sKulll-J/Stage_LoRa_2024/VSE_R&S/example complet.JPG

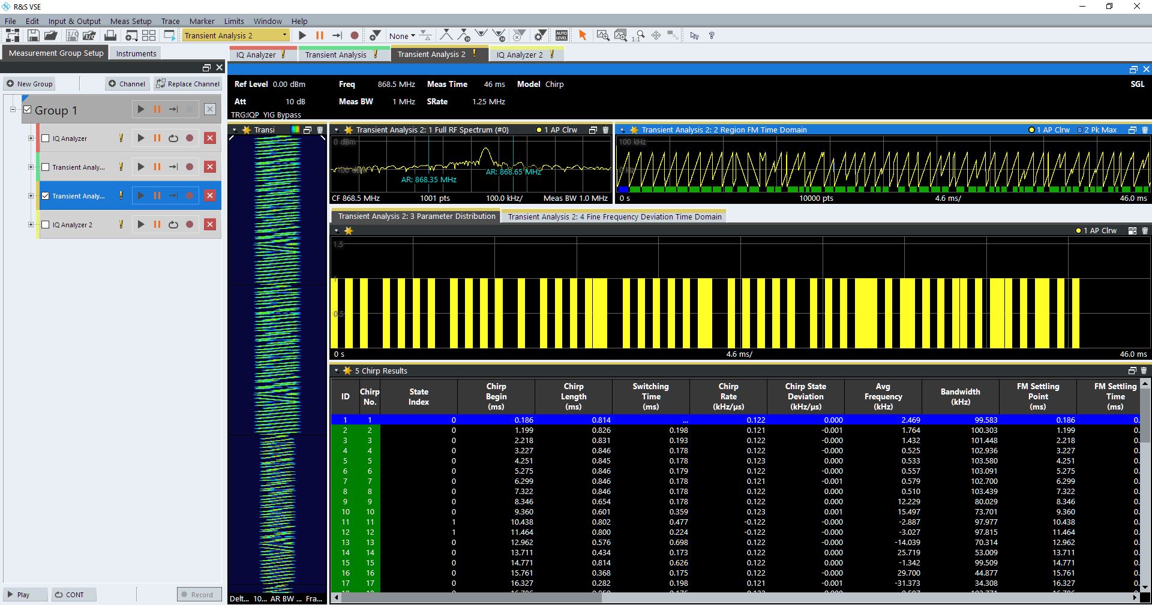
VSE_R&S/example complet.JPG
