sKulll-J/Stage_LoRa_2024/VSE_R&S/new_mode_1.JPG

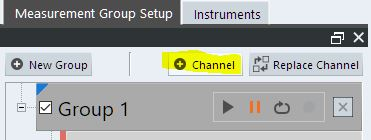
VSE_R&S/new_mode_1.JPG
