sKulll-J/Stage_LoRa_2024/CapteursInfos/AnalyseLora/SF7_s1_pw6.JPG

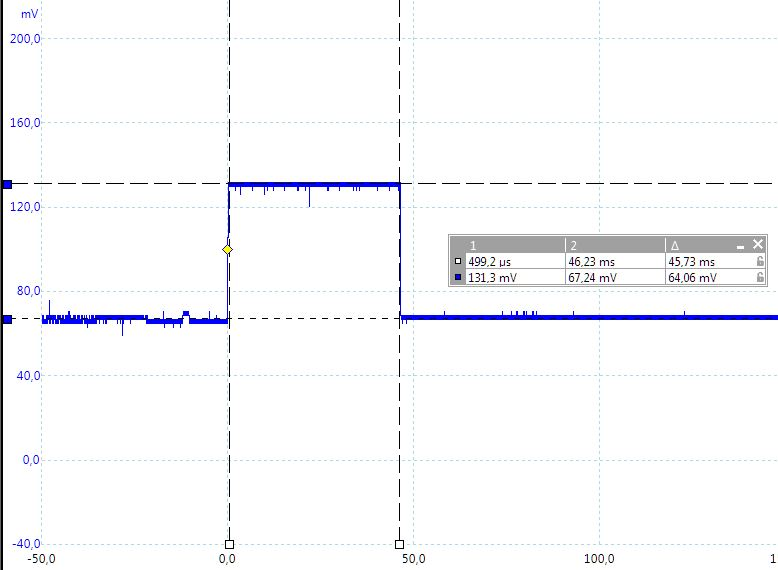
CapteursInfos/AnalyseLora/SF7_s1_pw6.JPG
