sKulll-J/Stage_LoRa_2024/CapteursInfos/AnalyseLora/SF7_s50_pw14.JPG

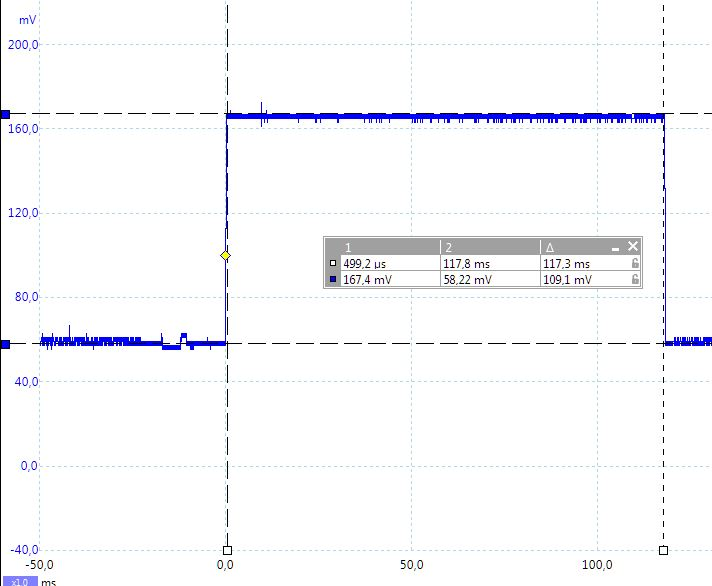
CapteursInfos/AnalyseLora/SF7_s50_pw14.JPG
