sKulll-J/Stage_LoRa_2024/CapteursInfos/AnalyseLora/SF9_s1_pw14.JPG

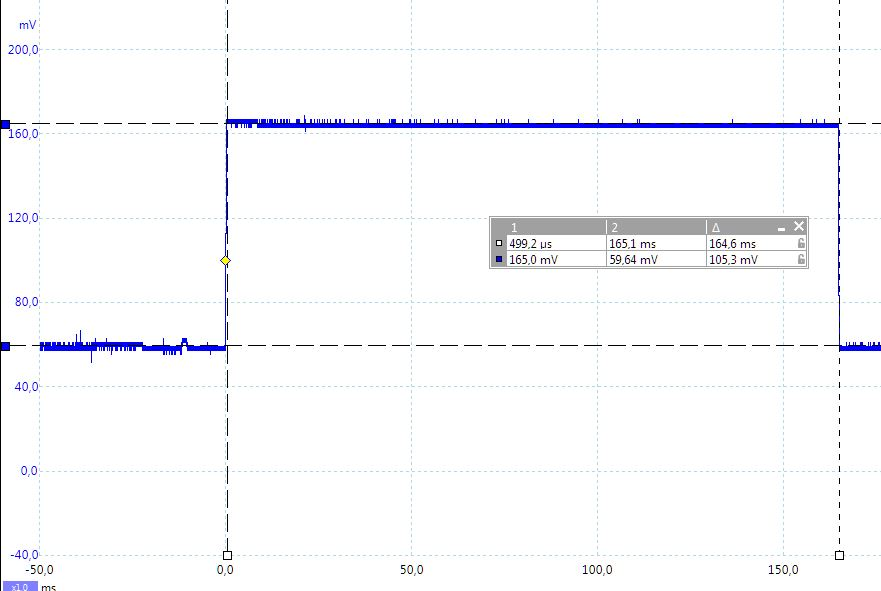
CapteursInfos/AnalyseLora/SF9_s1_pw14.JPG
