sKulll-J/Stage_LoRa_2024/CapteursInfos/AnalyseLora/SF10_s1_pw14.JPG

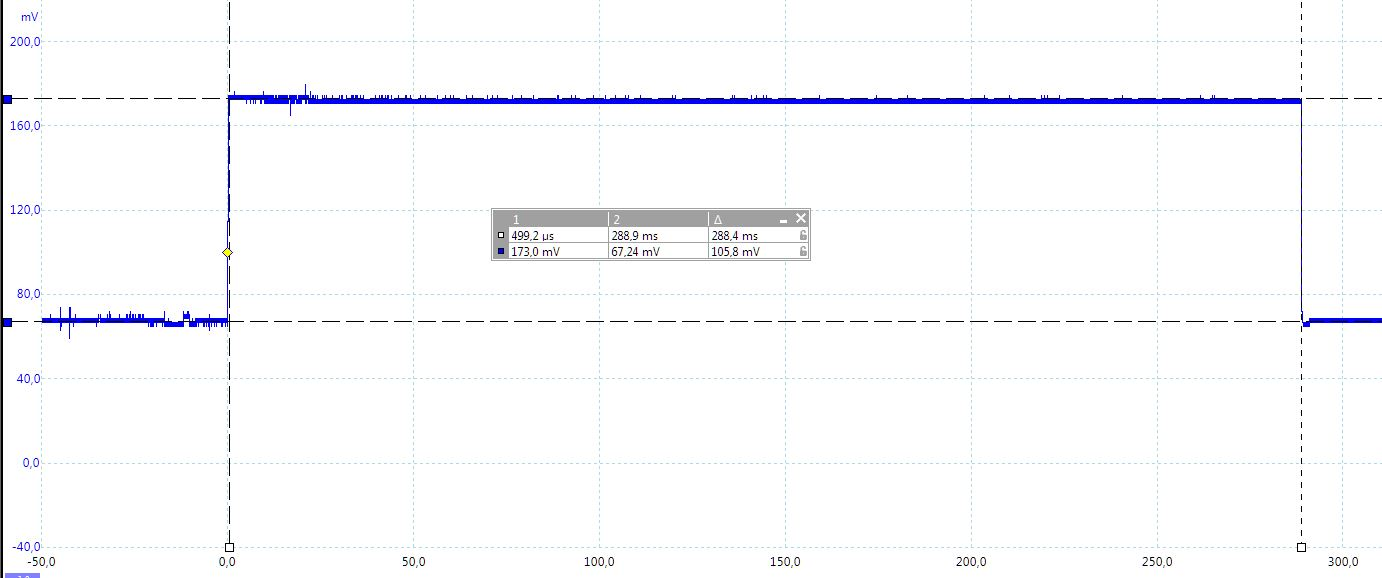
CapteursInfos/AnalyseLora/SF10_s1_pw14.JPG
