sKulll-J/Stage_LoRa_2024/CapteursInfos/DHT22/trame_0.JPG

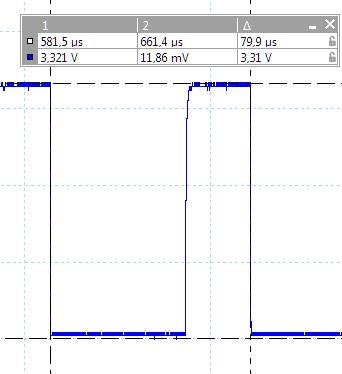
CapteursInfos/DHT22/trame_0.JPG
