sKulll-J/Stage_LoRa_2024/CapteursInfos/DHT22/trame_dht.JPG

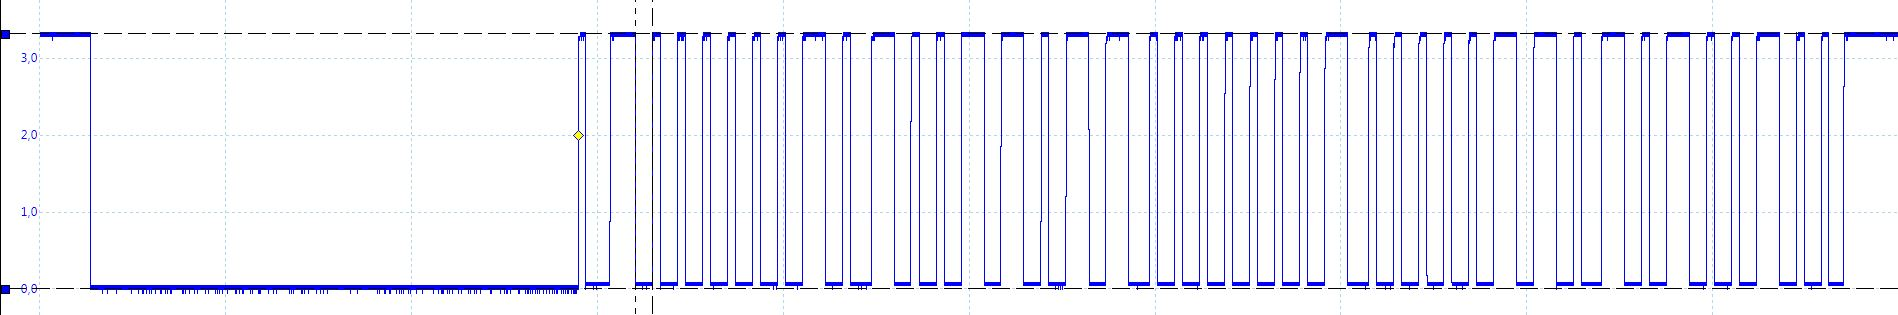
CapteursInfos/DHT22/trame_dht.JPG
