sKulll-J/Stage_LoRa_2024/CapteursInfos/Poids/A+A-_0g.PNG

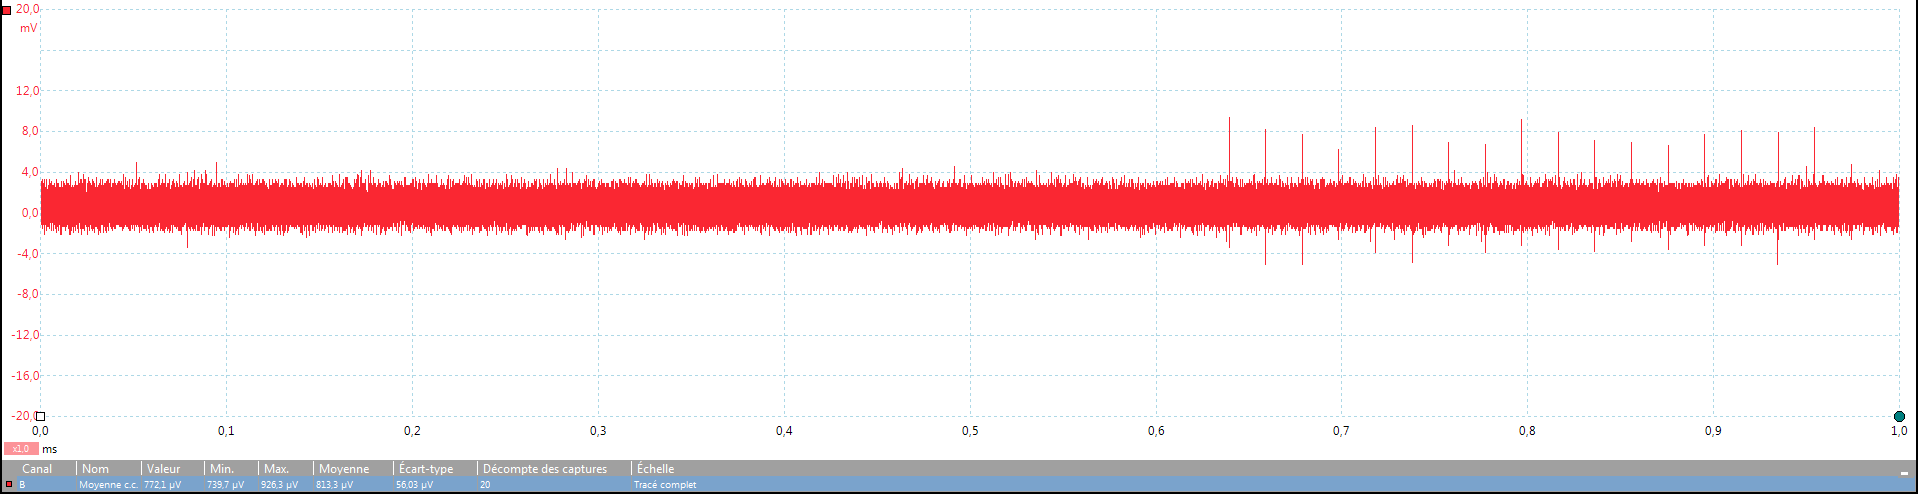
CapteursInfos/Poids/A+A-_0g.PNG
