sKulll-J/Stage_LoRa_2024/CapteursInfos/Poids/A+A-_2,59kg.PNG

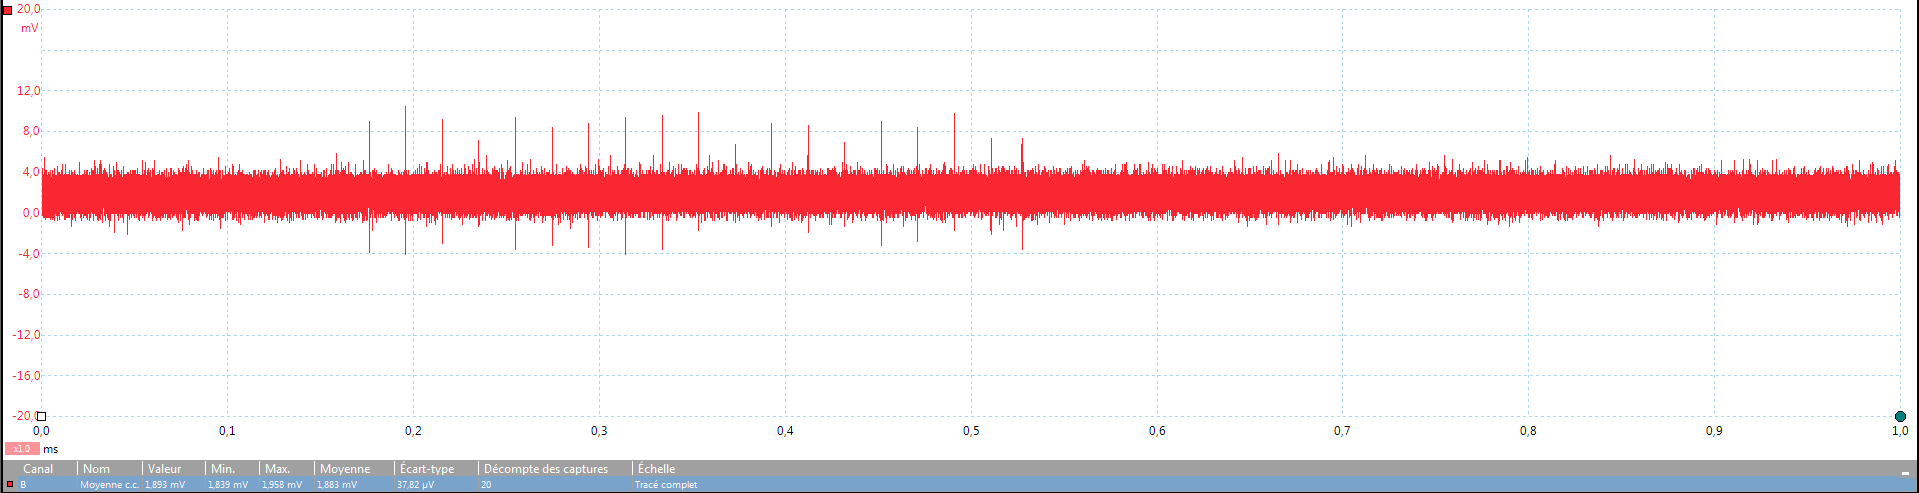
CapteursInfos/Poids/A+A-_2,59kg.PNG
