sKulll-J/Stage_LoRa_2024/CapteursInfos/Poids/ajout_poids.PNG

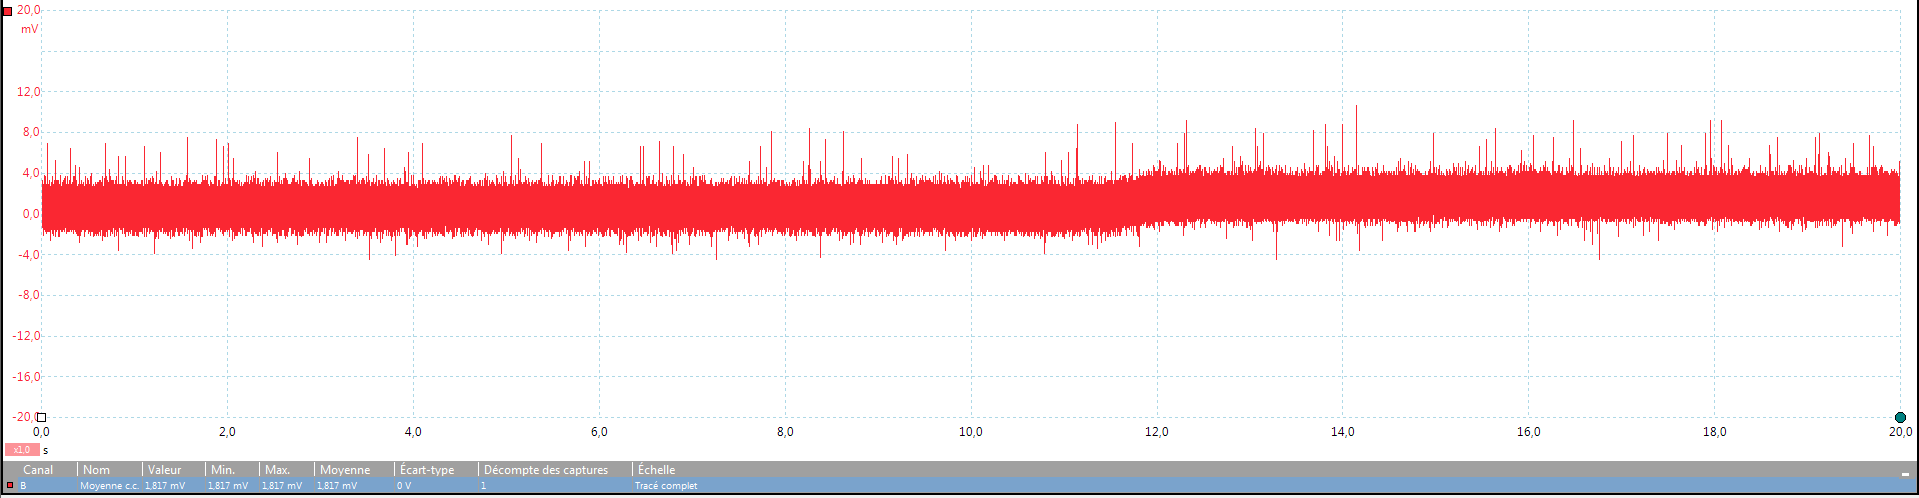
CapteursInfos/Poids/ajout_poids.PNG
