sKulll-J/Stage_LoRa_2024/CapteursInfos/Poids/poids_0.PNG

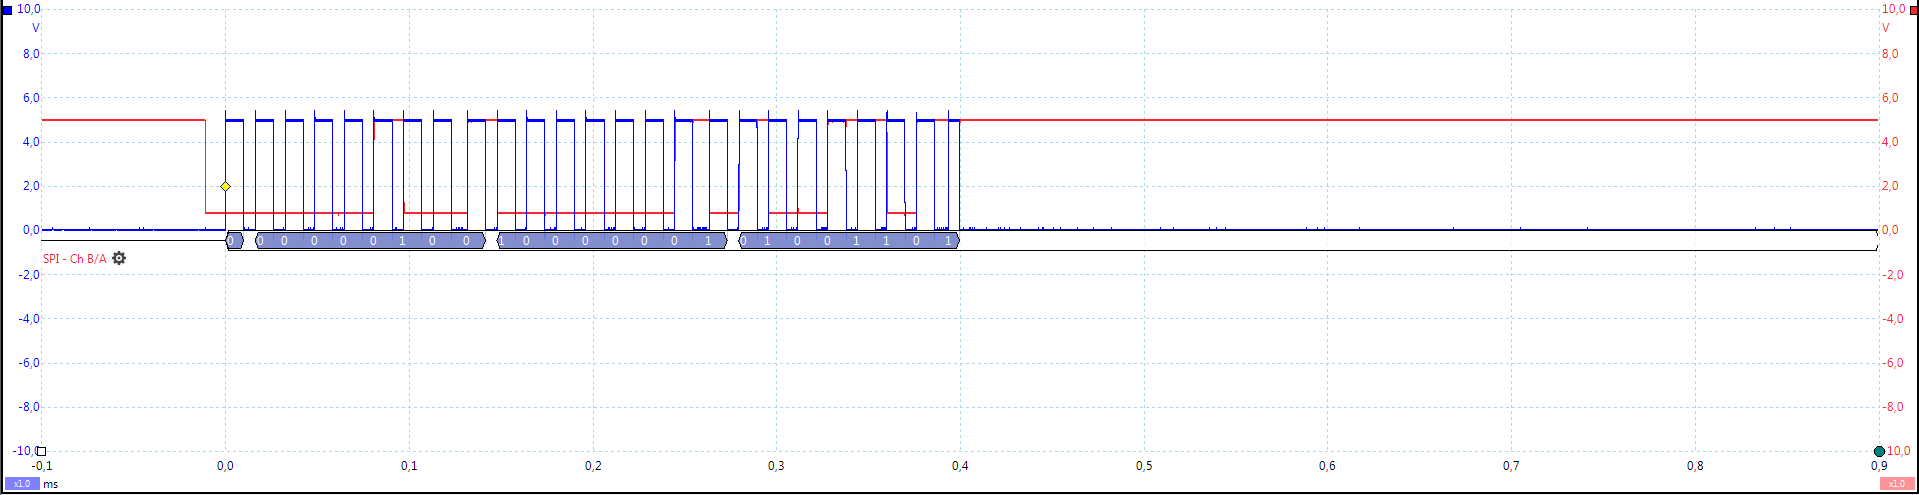
CapteursInfos/Poids/poids_0.PNG
