sKulll-J/Stage_LoRa_2024/CapteursInfos/Poids/poids_2.6.PNG

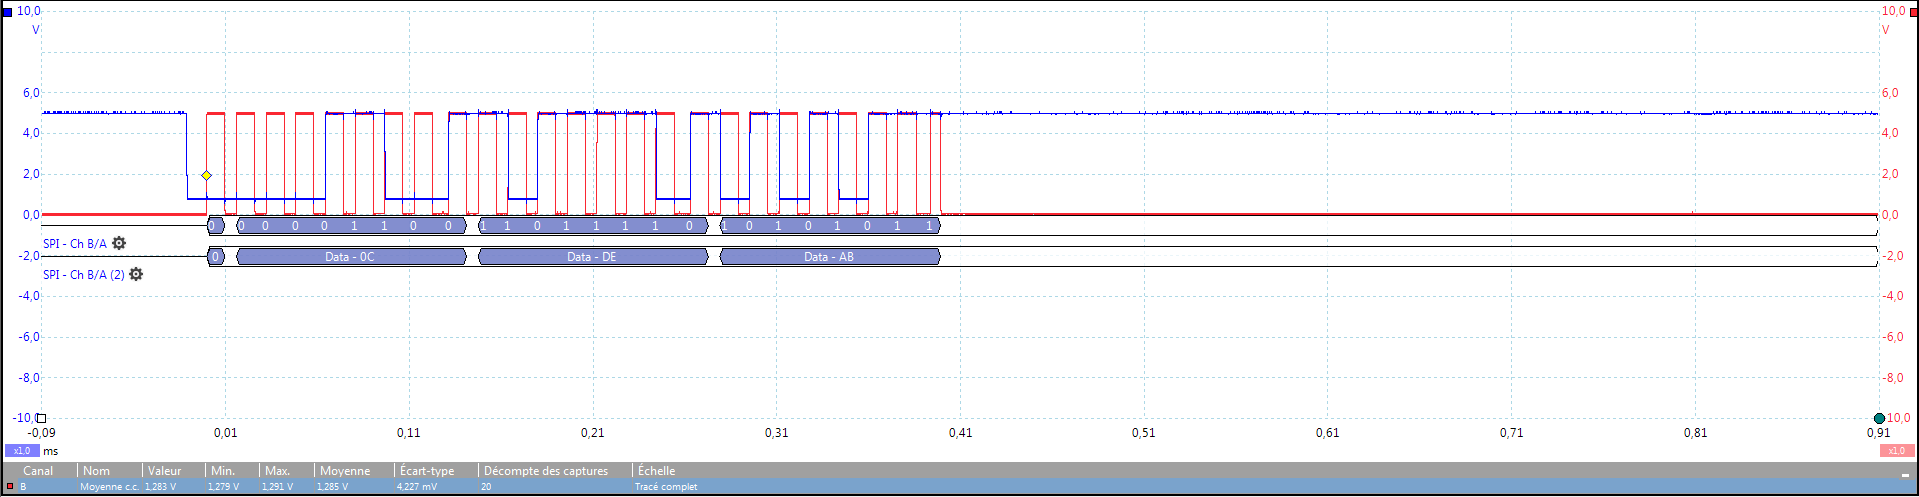
CapteursInfos/Poids/poids_2.6.PNG
