sKulll-J/Stage_LoRa_2024/CapteursInfos/Poids/STM32/Conso_All.JPG

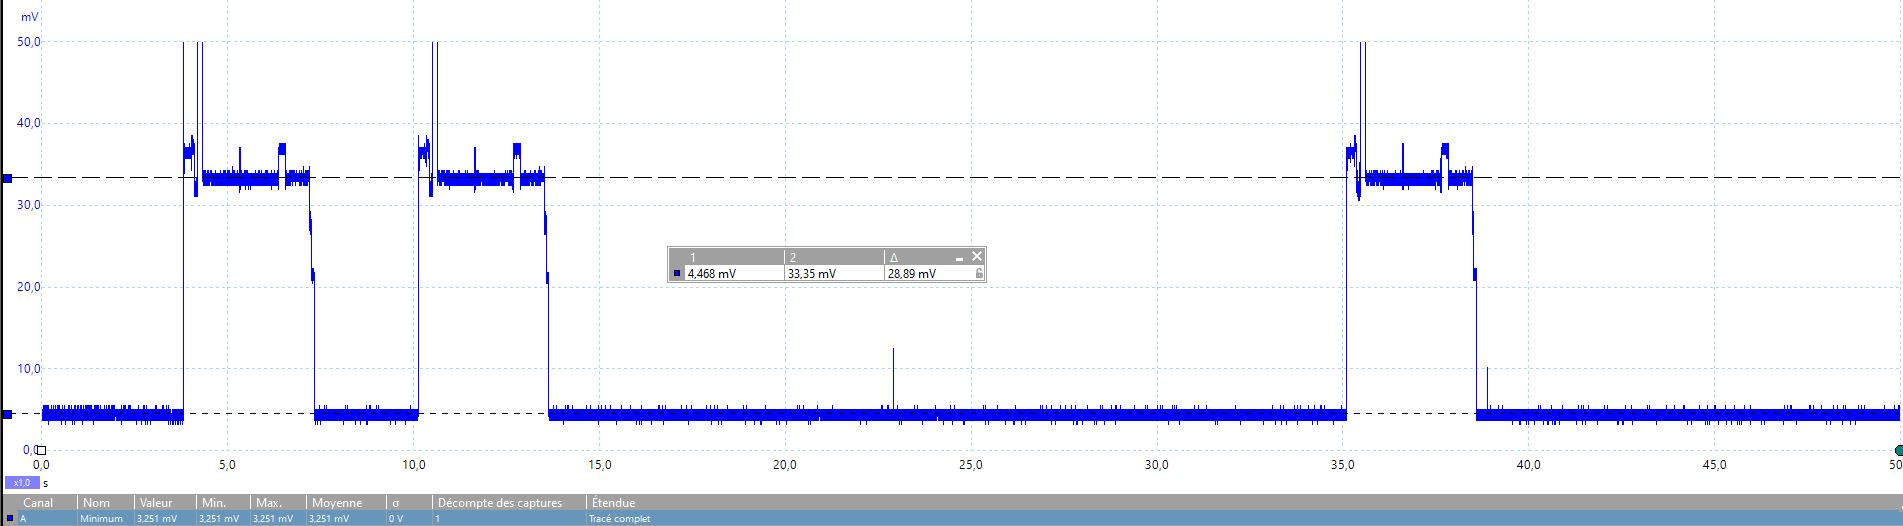
CapteursInfos/Poids/STM32/Conso_All.JPG
