sKulll-J/Stage_LoRa_2024/CapteursInfos/Poids/STM32/POIDS/trame.JPG

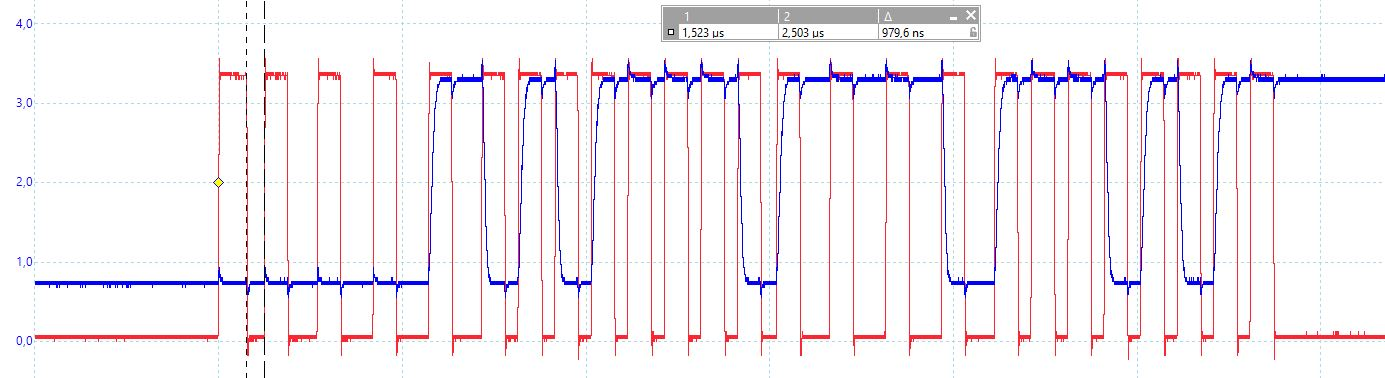
CapteursInfos/Poids/STM32/POIDS/trame.JPG
