sKulll-J/Stage_LoRa_2024/CapteursInfos/Poids/STM32/POIDS/val_rl_expl.JPG

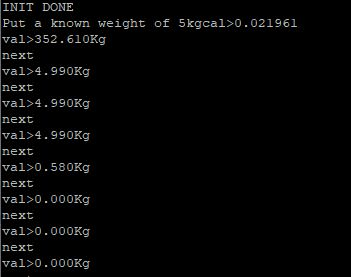
CapteursInfos/Poids/STM32/POIDS/val_rl_expl.JPG
