sKulll-J/Stage_LoRa_2024/CapteursInfos/SHT31/sht31_write.JPG

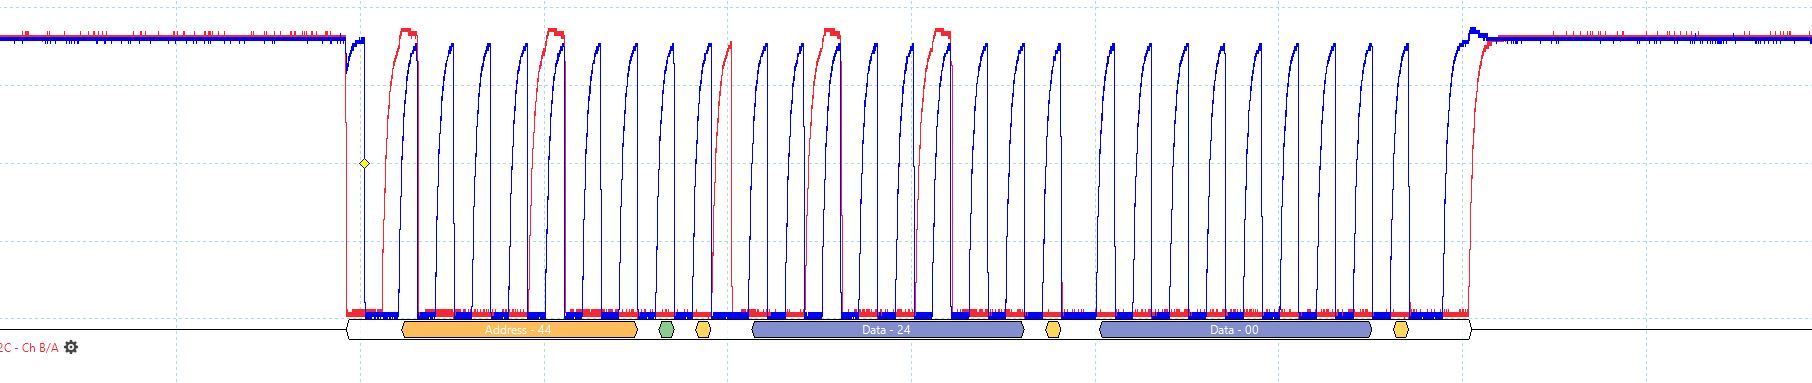
CapteursInfos/SHT31/sht31_write.JPG
