sKulll-J/Stage_LoRa_2024/VSE_R&S/dongle_connect.JPG

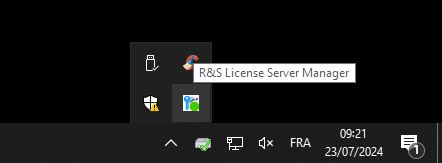
VSE_R&S/dongle_connect.JPG
