sKulll-J/Stage_LoRa_2024/VSE_R&S/dongle_connect_2.JPG

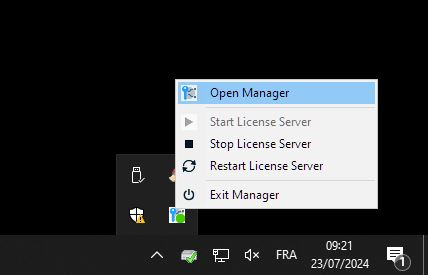
VSE_R&S/dongle_connect_2.JPG
