sKulll-J/Stage_LoRa_2024/VSE_R&S/example.JPG

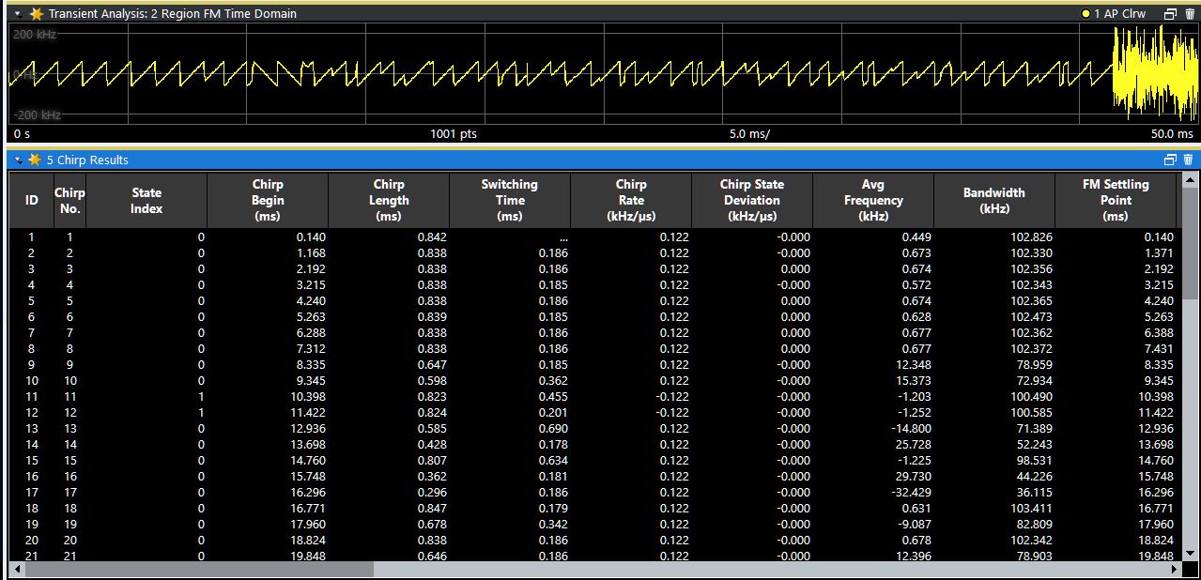
VSE_R&S/example.JPG
