sKulll-J/Stage_LoRa_2024/VSE_R&S/expl.JPG

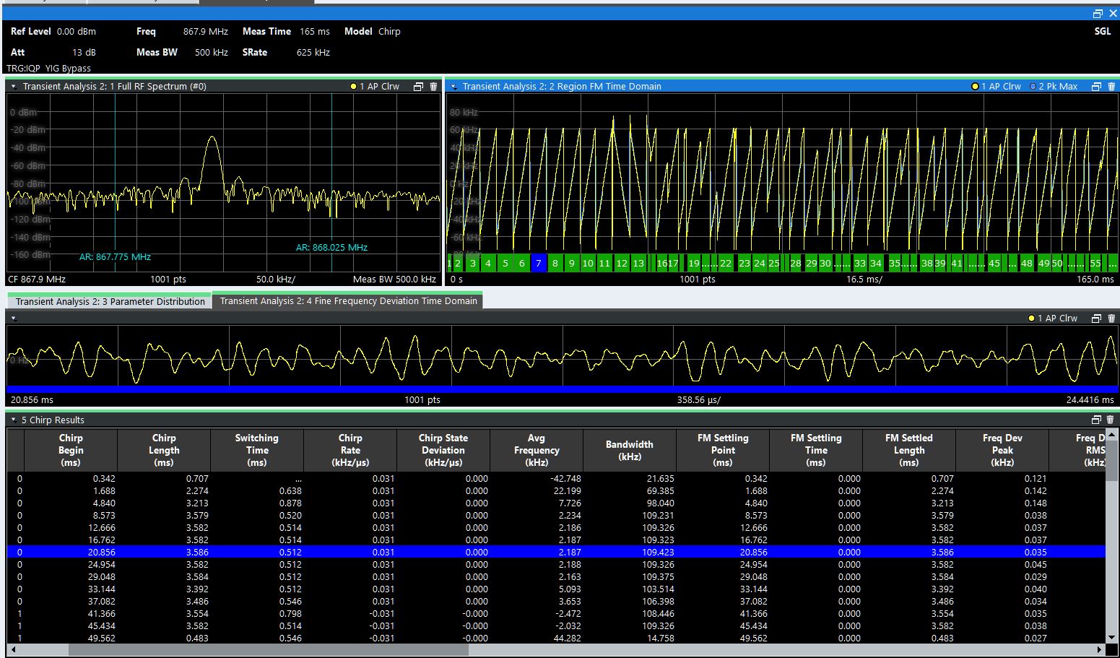
VSE_R&S/expl.JPG
