sKulll-J/Stage_LoRa_2024/VSE_R&S/save_config_1.JPG

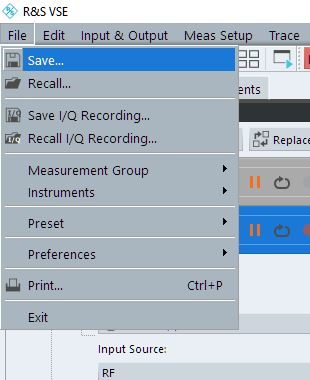
VSE_R&S/save_config_1.JPG
