sKulll-J/Stage_LoRa_2024/3D_Model/Boitier_Visualisation_Taraudage1.FCStd

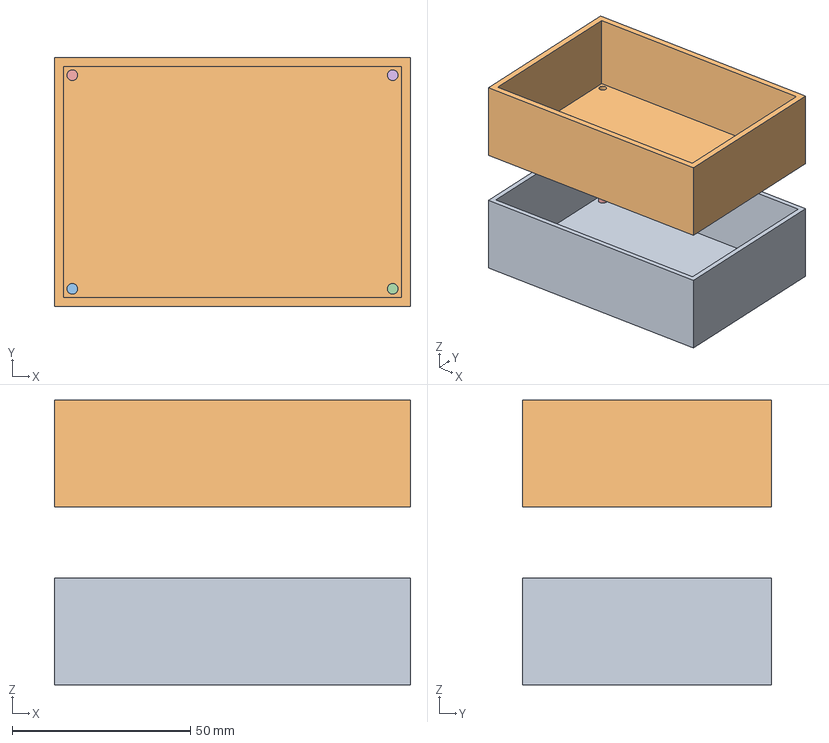
[picture p45: CAD file, 2025-02-11]
3D_Model/Boitier_Visualisation_Taraudage1.FCStd
100.0 x 70.0 x 80.0 mm
Base
Couvercle
Repere_Taraud
Repere_Taraud001
Repere_Taraud002
Repere_Taraud003
