sKulll-J/Stage_LoRa_2024/3D_Model/Pile_holder.FCStd

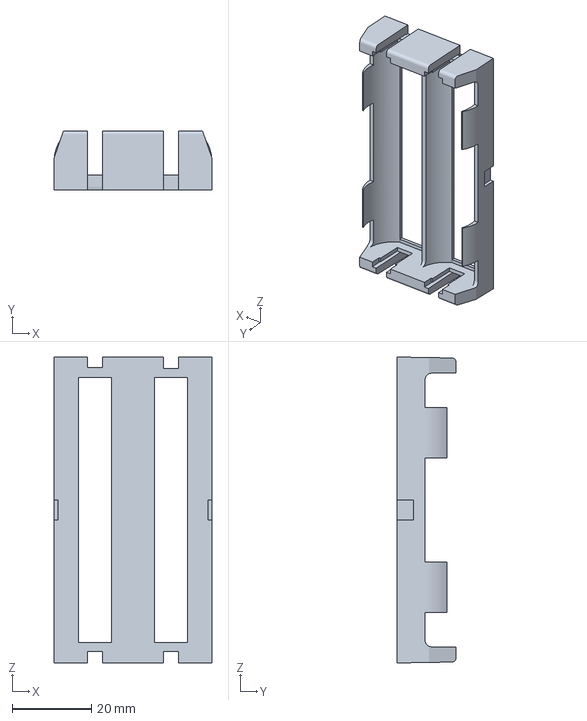
[picture p46: CAD file, 2025-02-11]
3D_Model/Pile_holder.FCStd
39.8 x 14.9 x 77.1 mm
