sKulll-J/Stage_LoRa_2024/3D_Model/piece centrale v20.3.stl

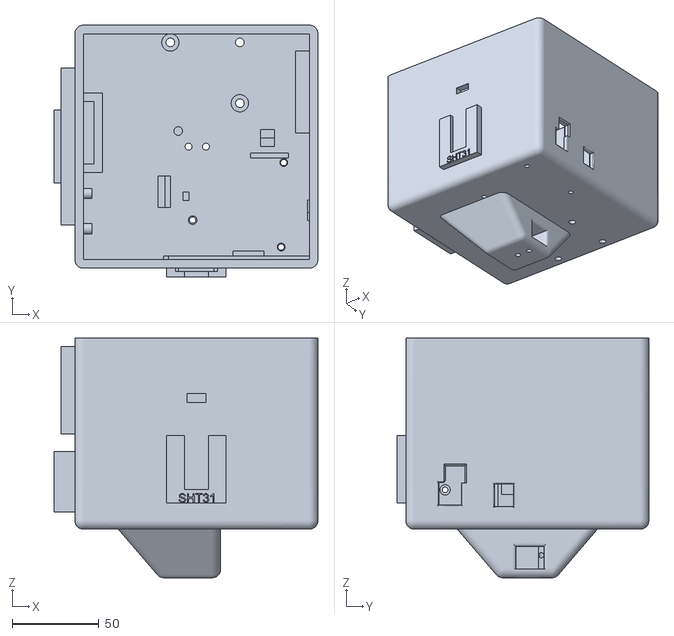
[picture p47: CAD file, 2024-08-23]
3D_Model/piece centrale v20.3.stl
152.0 x 145.0 x 138.0
