sKulll-J/Stage_LoRa_2024/(list of files, cad)

Other CAD files:
3D_Model/piece centrale v20.2.f3d
3D_Model/piece centrale v20.3.f3d
