sKulll-J/Stage_LoRa_2024/(list of files, drawings)

Other design files:
Fritzing/arduino.fzz
Fritzing/stm32.fzz
