sKulll-J/Stage_LoRa_2024/Stm32/LoraATCommandes/LoraATCommandes.ioc

Mcu.UserName=STM32L476RGTx
PA0.GPIO_Label=Lora_TX
PA0.Signal=UART4_TX
PA1.GPIO_Label=Lora_RX
PA1.Signal=UART4_RX
PA10.Signal=USART1_RX
PA2.GPIO_Label=USART_TX
PA2.Signal=USART2_TX
PA3.GPIO_Label=USART_RX
PA3.Signal=USART2_RX
PA5.GPIO_Label=LD2 [green Led]
PA5.Signal=GPIO_Output
PA9.Signal=USART1_TX
PC13.GPIO_Label=B1 [Blue PushButton]
PC13.Signal=GPXTI13
