sKulll-J/Stage_LoRa_2024/Stm32/poid_mes/Core/Src/main.c

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
/* Includes ------------------------------------------------------------------*/
#include "main.h"

/* USER CODE BEGIN Includes */
#include "lib_sen7.h"
/* USER CODE END Includes */

TIM_HandleTypeDef htim1;

UART_HandleTypeDef huart2;

void SystemClock_Config(void);
static void MX_GPIO_Init(void);
static void MX_USART2_UART_Init(void);
static void MX_TIM1_Init(void);
/**
  * @brief  The application entry point.
  * @retval int
  */
int main(void)
{

  /* USER CODE BEGIN 1 */
uint32_t zer;
  /* USER CODE END 1 */

  /* MCU Configuration--------------------------------------------------------*/

  /* Reset of all peripherals, Initializes the Flash interface and the Systick. */
  HAL_Init();

  /* Configure the system clock */
  SystemClock_Config();

  /* Initialize all configured peripherals */
  MX_GPIO_Init();
  MX_USART2_UART_Init();
  MX_TIM1_Init();
  /* USER CODE BEGIN 2 */

  HAL_UART_Transmit(&huart2, (uint8_t*)"INIT DONE\r\n", 11, 20);


  HAL_TIM_Base_Start(&htim1);


  SEN7_Init(&htim1, SEN7_SCK_GPIO_Port, SEN7_SCK_Pin, SEN7_DT_GPIO_Port, SEN7_DT_Pin, SEN7_GAIN_32);
  HAL_Delay(1000);

  zer=SEN7_Tare();

  HAL_UART_Transmit(&huart2, (uint8_t*)"Put a known weight of 5kg\r\n", 25, 20);
  HAL_Delay(5000);
  char msg[20];
  sprintf(msg, "cal>%f\r\n",SEN7_Calibrate(500));
  HAL_UART_Transmit(&huart2, (uint8_t*)msg, strlen(msg), 60);


  /* USER CODE END 2 */

  /* Infinite loop */
  /* USER CODE BEGIN WHILE */
  while (1)
  {

	  char msg1[20];
	  	  sprintf(msg1, "raw>%d\r\n",SEN7_GetRaw());
	  	  HAL_UART_Transmit(&huart2, (uint8_t*)msg1, strlen(msg1), 60);
HAL_Delay(300);
	  char msg[20];
	  sprintf(msg, "val>%0.3fKg\r\n",SEN7_GetWeight());
	  HAL_UART_Transmit(&huart2, (uint8_t*)msg, strlen(msg), 60);

	  HAL_UART_Transmit(&huart2, (uint8_t*)"next\r\n", 6, 20);
	  HAL_Delay(1000);
    /* USER CODE END WHILE */

    /* USER CODE BEGIN 3 */
  }
  /* USER CODE END 3 */
}

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
