sKulll-J/Stage_LoRa_2024/Stm32/ruche_v1/Core/Src/main.c

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
/* Includes ------------------------------------------------------------------*/
#include "main.h"

/* USER CODE BEGIN Includes */
#include <stdio.h>
#include <string.h>

#include "lib_dht22.h"
/* USER CODE END Includes */

ADC_HandleTypeDef hadc1;

RTC_HandleTypeDef hrtc;

TIM_HandleTypeDef htim3;

UART_HandleTypeDef huart4;
UART_HandleTypeDef huart1;
UART_HandleTypeDef huart2;
DMA_HandleTypeDef hdma_uart4_rx;
DMA_HandleTypeDef hdma_usart1_rx;
DMA_HandleTypeDef hdma_usart2_rx;

void SystemClock_Config(void);
static void MX_GPIO_Init(void);
static void MX_DMA_Init(void);
static void MX_USART2_UART_Init(void);
static void MX_RTC_Init(void);
static void MX_UART4_Init(void);
static void MX_USART1_UART_Init(void);
static void MX_ADC1_Init(void);
static void MX_TIM3_Init(void);
/* USER CODE BEGIN 0 */
#define SERIAL_INPUT 1 // a 0 si sans ST-Link

#define RX_BUFF_SIZE 200
#define MAIN_BUFF_SIZE 200
#define MSG_SIZE 70

#define SLEEP_TIME 30 //2min

UART_HandleTypeDef *lora = &huart4;
UART_HandleTypeDef *serial = &huart2;  //modifier si sans ST-link

uint8_t rcvbff[RX_BUFF_SIZE];
uint8_t mainbff[MAIN_BUFF_SIZE];

char message[MSG_SIZE];

int at_rdy = 0;
int joined_rdy = 0;
int message_rdy = 0;
int veille_rdy = 0;
int get_data = 0;
int error =0;
int wait_msg=0;

typedef struct{
	int Hi;
	float Ti;
	int Ho;
	float To;
	int presence ;
	int poids;
	float battery;
}DatasStruct;
DatasStruct myDatas;

void HAL_UARTEx_RxEventCallback(UART_HandleTypeDef *huart, uint16_t Size)
{
	#if SERIAL_INPUT
	if(huart == serial)  //huart->Instance == USART2
	{
		memcpy(mainbff, rcvbff, Size);
		uint8_t tmpbff[strlen(rcvbff)+1];
					tmpbff[0]='>';
					memcpy(&tmpbff[1], rcvbff, strlen(rcvbff));

					HAL_UART_Transmit(serial,(uint8_t*)tmpbff,strlen(rcvbff)+1,10);

		HAL_UART_Transmit(lora,(uint8_t*)rcvbff,strlen(rcvbff),10);



		for(int i=0; i<RX_BUFF_SIZE; i++)
			rcvbff[i] = 0x00;
		rcvbff[0] = '\0';

		HAL_UARTEx_ReceiveToIdle_DMA(serial, rcvbff, RX_BUFF_SIZE);
		__HAL_DMA_DISABLE_IT(&hdma_usart2_rx, DMA_IT_HT);
	}
	#endif
	if(huart == lora)  //huart->Instance == USART2
		{
			memcpy(mainbff, rcvbff, Size);


			HAL_UART_Transmit(serial,(uint8_t*)rcvbff,strlen(rcvbff),60);



			if(strstr(rcvbff, "+MSG: Done\r\n")!=NULL)
			{
				HAL_UART_Transmit(serial,(uint8_t*)"Valid data\n",11,10);
				 // pret a envoyer un nouveau message
				veille_rdy=1;
				wait_msg = 0;
			}
			if(strstr(rcvbff, "+AT: OK\r\n")!=NULL || strstr(rcvbff, "+LOWPOWER: WAKEUP\r\n")!=NULL)
			{
				at_rdy=1; // pret a envoyer un nouveau message
				wait_msg=0;
			}
			if(strstr(rcvbff, "+JOIN: Network joined\r\n")!=NULL || strstr(rcvbff, "+JOIN: Joined already\r\n")!=NULL)
			{
				joined_rdy=1; // pret a envoyer un nouveau message
				HAL_UART_Transmit(serial,(uint8_t*)"Ready to send\n",14,10);
				get_data=1;
				wait_msg=0;
			}

			HAL_UART_Transmit(serial,(uint8_t*)"____\n",5,10);

			for(int i=0; i<RX_BUFF_SIZE; i++)
				rcvbff[i] = 0x00;
			rcvbff[0] = '\0';

			HAL_UARTEx_ReceiveToIdle_DMA(lora, rcvbff, RX_BUFF_SIZE);
			__HAL_DMA_DISABLE_IT(&hdma_uart4_rx, DMA_IT_HT);
		}
}
/* USER CODE END 0 */

/**
  * @brief  The application entry point.
  * @retval int
  */
int main(void)
{
  /* MCU Configuration--------------------------------------------------------*/

  /* Reset of all peripherals, Initializes the Flash interface and the Systick. */
  HAL_Init();

  /* Configure the system clock */
  SystemClock_Config();

  /* Initialize all configured peripherals */
  MX_GPIO_Init();
  MX_DMA_Init();
  MX_USART2_UART_Init();
  MX_RTC_Init();
  MX_UART4_Init();
  MX_USART1_UART_Init();
  MX_ADC1_Init();
  MX_TIM3_Init();
  /* USER CODE BEGIN 2 */
  DHT_Init(DHT_GPIO_Port, DHT_Pin, &htim3);

  HAL_UART_Transmit(serial, (uint8_t *)"UART2 INIT\n" , 11, 10);

    //uint8_t premessage[55] = "AT+MSG\r\n";

    HAL_GPIO_WritePin(LD2_GPIO_Port, LD2_Pin, SET);
    HAL_Delay(100);
    DHT_Init(DHT_GPIO_Port, DHT_Pin, &htim3);
    HAL_GPIO_TogglePin(LD2_GPIO_Port, LD2_Pin);
  //HAL_PWREx_EnableFlashPowerDown();
  //HAL_PWREx_EnableLowPowerRunMode();

  /* Enter Stop Mode*/

  //HAL_TIM_Base_Start_IT(&htim16);

	 //timer_val = __HAL_TIM_GET_COUNTER(&htim16);

  HAL_RTCEx_SetWakeUpTimer_IT(&hrtc, SLEEP_TIME, RTC_WAKEUPCLOCK_CK_SPRE_16BITS);

  HAL_UARTEx_ReceiveToIdle_DMA(serial, rcvbff, RX_BUFF_SIZE);
  __HAL_DMA_DISABLE_IT(&hdma_usart2_rx, DMA_IT_HT);

  HAL_UARTEx_ReceiveToIdle_DMA(lora, rcvbff, RX_BUFF_SIZE);
  __HAL_DMA_DISABLE_IT(&hdma_uart4_rx, DMA_IT_HT);

  //HAL_GPIO_Init(Presence_GPIO_Port, Presence_Pin);
  /* USER CODE END 2 */

  /* Infinite loop */
  /* USER CODE BEGIN WHILE */
  while (1)
  {
    /* USER CODE END WHILE */

    /* USER CODE BEGIN 3 */
	//HAL_GPIO_WritePin(LD2_GPIO_Port, LD2_Pin, GPIO_PIN_SET);
	/*LoRa send*/

	  if(!at_rdy && !wait_msg )
	  {
		  verifcation_rep();//necessaire car sinon la premiere demande de donnée ne se fait pas
		  HAL_Delay(200);//pour espacer deux demandes au DHT22
		  HAL_UART_Transmit(lora, (uint8_t *)"AT\r\n" , 4, 10);
		  wait_msg=1;
	  }
	  else if(at_rdy && !wait_msg && !joined_rdy)
	  {
		  HAL_UART_Transmit(lora, (uint8_t *)"AT+JOIN\r\n" , 9, 10);
		  wait_msg=1;
	  }
	  else if(joined_rdy && get_data && !message_rdy)
	  {
		  //humidite
		  DHT_GetValue();
		  //if(verifcation_rep()==1)
		  //HAL_UART_Transmit(&huart2, (uint8_t *) "verif\n", 6, 20);
		  myDatas.Hi = (int)DHT_GetHumi();
		  myDatas.Ho = 0;

		  //températures
		  myDatas.Ti = DHT_GetTemp();
		  myDatas.To = 0.0;

		  //poids
		  myDatas.poids = 00;

		  //presence
		  myDatas.presence = (HAL_GPIO_ReadPin(PresPins_GPIO_Port, PresPins_Pin)!=GPIO_PIN_SET);

		  //battery
		  HAL_ADC_Init(&hadc1);
		  HAL_Delay(60);
		  HAL_GPIO_WritePin(LD2_GPIO_Port,LD2_Pin, GPIO_PIN_SET);
		  uint16_t value_adc = 0;
		  HAL_ADC_Start(&hadc1);
		  HAL_ADC_PollForConversion(&hadc1, 1000);
		  value_adc =HAL_ADC_GetValue(&hadc1);

		  HAL_ADC_Stop(&hadc1);
		  HAL_GPIO_WritePin(LD2_GPIO_Port,LD2_Pin, GPIO_PIN_RESET);
		  HAL_ADC_DeInit(&hadc1);

		  myDatas.battery = (value_adc*5.069/4095);

		  //set message to send
		  sprintf(message,"AT+MSG=\"Ti:%0.2f,Hi:%d,To:%0.2f,Ho:%d,Pr:%d,Pd:%0.2f,Bt:%0.2f\"\r\n",myDatas.Ti,myDatas.Hi,myDatas.To,myDatas.Ho,myDatas.presence,myDatas.poids/1000.0, myDatas.battery);
///Ti:([-]?\d*\.?\d+),Hi:(\d+),To:([-]?\d*\.?\d+),Ho:(\d+),Pr:(\d+),Pd:([-]?\d*\.?\d+),Bt:([-]?\d*\.?\d+)/

		  get_data=0;
		  message_rdy=1;

		  HAL_UART_Transmit(serial, (uint8_t *)"stp >38\n" ,7 , 10);
	  }
	  else if(joined_rdy && message_rdy)
	  {

		  HAL_UART_Transmit(serial, (uint8_t *)"send >" ,6 , 10);

		  HAL_UART_Transmit(serial, (uint8_t *)message , strlen(message), 70);
		  HAL_UART_Transmit(lora, (uint8_t *)message , strlen(message), 70);
		  message_rdy=0;
		  wait_msg=1;
	  }
	  else if(!error && joined_rdy  && !message_rdy && veille_rdy)
	  {
		  /*preSTOP mode*/

		  HAL_UART_Transmit(lora, (uint8_t *)"AT+LOWPOWER\n\r" , 13, 60);
		  HAL_GPIO_WritePin(LD2_GPIO_Port,LD2_Pin, GPIO_PIN_RESET);
		 HAL_UART_Transmit(serial, (uint8_t *)"Start sleep\n" , 12, 10);
		  HAL_Delay(100);
		HAL_SuspendTick();
		//HAL_RTCEx_SetWakeUpTimer_IT(&hrtc, 4098, RTC_WAKEUPCLOCK_RTCCLK_DIV16);
		HAL_RTCEx_SetWakeUpTimer_IT(&hrtc, SLEEP_TIME, RTC_WAKEUPCLOCK_CK_SPRE_16BITS);

		/* Enter STOP 2 mode */
		HAL_PWREx_EnterSTOP2Mode(PWR_STOPENTRY_WFI);
		HAL_RTCEx_DeactivateWakeUpTimer(&hrtc);
		SystemClock_Config();
		HAL_ResumeTick();

		  HAL_UART_Transmit(lora, (uint8_t *)"AT\n\r" , 4, 60); // reveille le lora
		 HAL_UART_Transmit(serial, (uint8_t *)"Wake up\n" , 8, 60);
		  HAL_GPIO_WritePin(LD2_GPIO_Port,LD2_Pin, GPIO_PIN_SET);

		  MX_ADC1_Init();
		  HAL_Delay(200);
		get_data=1;
		veille_rdy=0;
	  }
	/*green led blink*/
	/*
	HAL_Delay(615);
	HAL_GPIO_WritePin(LD2_GPIO_Port, LD2_Pin, GPIO_PIN_RESET);
	HAL_Delay(285);
	HAL_GPIO_WritePin(LD2_GPIO_Port, LD2_Pin, GPIO_PIN_SET);
	HAL_Delay(100);
	HAL_GPIO_WritePin(LD2_GPIO_Port, LD2_Pin, GPIO_PIN_RESET);
*/


  }
  /* USER CODE END 3 */
}

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
/* USER CODE BEGIN 4 */

//callback

/*void HAL_TIM_PeriodElapsedCallback(TIM_HandleTypeDef *tim)
{
	if(tim == &htim16)
	{
		HAL_GPIO_TogglePin(LD2_GPIO_Port, LD2_Pin);
	}
}*/
/*void HAL_TIM_PeriodElapsedCallback(LPTIM_HandleTypeDef *lptim)
{
	if(lptim == &hlptim1)
	{
		//HAL_GPIO_TogglefPin(LD2_GPIO_Port, LD2_Pin);
	}
}*/
void HAL_RTC_AlarmAEventCallback(RTC_HandleTypeDef *hrtc) {
	HAL_GPIO_TogglePin(LD2_GPIO_Port, LD2_Pin);

  RTC_AlarmTypeDef sAlarm;
  HAL_RTC_GetAlarm(hrtc,&sAlarm,RTC_ALARM_A,FORMAT_BIN);
  if(sAlarm.AlarmTime.Minutes>58) {
    sAlarm.AlarmTime.Minutes=0;
  }else{
    sAlarm.AlarmTime.Minutes=sAlarm.AlarmTime.Minutes+1;
  }
    //while(HAL_RTC_SetAlarm_IT(hrtc, &sAlarm, FORMAT_BIN)!=HAL_OK){}
    //HAL_GPIO_TogglePin(GPIOA, GPIO_PIN_5);
}

/* USER CODE END 4 */
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
