sKulll-J/Stage_LoRa_2024/Arduino/rep_15s/lora_e5.h

#ifndef LORA_E5_H_
#define LORA_E_H_

#include<SoftwareSerial.h>




#define MODE "ABP" // "OTAA" 
#define DR "7" //define data rate 0-7
#define CH "0" //define channel
#define PORT "1" //define port used 1-199


//TTN Infos
#define DevEui "70B3D57ED0067B7A"
#define DevAddr "260BEC30"
#define AppEui "0000000000000000"
#define NwksKey "E072735F512B40B4853D8CB694A68FDF"
#define AppsKey "1CB83DF99A750DA8DB9459891332E79D"




#endif
