sKulll-J/Stage_LoRa_2024/(commit log)

2024-07-15 First commit
    Fichiers principaux
    [arduino.fzz]
2024-08-23 Add new folders
    [10kp_exp.csv, 3kp_expl.csv, chirp2 .csv, chirp3.csv, chirp3_001.csv, chirp_data.csv, chirp_file.csv, piece centrale v20.2.f3d]
2025-02-11 Modele 3D
    [Boitier_Visualisation_Taraudage1.FCStd, Pile_holder.FCStd]
