sKulll-J/Stage_LoRa_2024/(notices)

Notices in the files:
Stm32/poid_mes/Core/Src/main.c:
Copyright (c) 2024 STMicroelectronics.
All rights reserved.
This software is licensed under terms that can be found in the LICENSE file
